hexa3/focus-buddy/BOM.csv

Item | Qty | Supplier | Cost/item | Total Cost | link
Seeed Studio XIAO ESP32-C3 | 1 | Seeed Studio | $4.90 | $4.90 | https://www.seeedstudio.com/Seeed-XIAO-ESP32C3-p-5431.html
2.9" e-paper module, Waveshare V2 | 1 | Waveshare | $21.99 | $21.99 | https://www.waveshare.com/2.9inch-e-paper-module.htm
Printed circuit board (5 pcs, 106x64 mm, 2 layer): paste JLCPCB quote | 1 | JLCPCB | $0.00 | $0.00 | https://jlcpcb.com/quote
Tactile switch 6x6 mm, 9.5 mm tall, through-hole | 3 | Tayda Electronics | $0.04 | $0.12 | https://www.taydaelectronics.com/tact-switch-6x6mm-9-5mm-through-hole-spst-no.html
Resistor 10 kΩ | 4 | Tayda Electronics | $0.02 | $0.08 | https://www.taydaelectronics.com/resistors/1-4w-metal-film-resistors.html
Resistor 1 MΩ | 2 | Tayda Electronics | $0.02 | $0.04 | https://www.taydaelectronics.com/resistors/1-4w-metal-film-resistors.html
Resistor 1 kΩ | 1 | Tayda Electronics | $0.02 | $0.02 | https://www.taydaelectronics.com/resistors/1-4w-metal-film-resistors.html
NPN transistor 2N3904, TO-92 | 1 | Futurlec | $0.06 | $0.06 | https://www.futurlec.com/Transistors/2N3904pr.shtml
Diode 1N4148 | 1 | Tayda Electronics | $0.02 | $0.02
Buzzer 12 mm, 3 V, 7.6 mm pin spacing | 1 | Tayda Electronics | $0.50 | $0.50
Capacitor 100 nF ceramic | 1 | Tayda Electronics | $0.02 | $0.02
Pin header 1x8 male, 2.54 mm | 1 | Tayda Electronics | $0.05 | $0.05
Male pin header 1x7, 2.54 mm | 2 | Tayda Electronics | $0.05 | $0.10
JST-PH 2-pin socket, vertical (B2B-PH-K) | 1 | Tayda Electronics | $0.10 | $0.10
LiPo battery 3.7 V | 1 | Any | $5.00 | $5.00
Screw M3 x 20 mm | 4 | Any hardware store | $0.10 | $0.40
Double-sided foam tape | 1 | Any | $1.00 | $1.00
PLA or PETG filament | 1 | Any | $2.20 | $2.20
Estimated total shipping | 1 |  | $0.00 | $0.00
Estimated total shipping | 1 |  |  | $0.00
