hexa3/focus-buddy/hardware/cad/pcb_positions.scad

// GENERATED by tools/gen_cad_params.py from the PCB. Do not edit by hand.
pcb_w = 106.0;
pcb_h = 64.0;
pcb_holes = [[-49.5, 28.5], [49.5, 28.5], [-49.5, -28.5], [49.5, -28.5]];
pcb_switches = [[-20.0, -23.0], [0.0, -23.0], [20.0, -23.0]];
pcb_display_center = [0.0, 9.0];
display_module = [89.5, 38.0];
pcb_xiao_center = [41.0, 2.0];  // USB-C points +X
pcb_cable_slot = [[-44.5, -4.0], [-40.0, 20.0]];
