hexa3/focus-buddy/JOURNAL.md

# Vicar: devlog

<!-- Generated by Half Life from project k4ep6hjw5rflj7knygj98lg3. Edits here are overwritten on the next sync. -->
<!-- Generated: 2026-11-01T14:42:42.248Z -->

> [!NOTE]
> This devlog is mirrored from [Half Life](https://halflife.hackclub.com) ([open the project](https://halflife.hackclub.com/projects/k4ep6hjw5rflj7knygj98lg3)). Editing it here will not change the platform's copy, and the next sync overwrites this file.

> An e-paper screen that updates over bluetooth that shows a timer and helps you stay on track on work. you can use it to play games if you need a break from working

| Week | Tier | Hours logged | Entries |
| --- | --- | --- | --- |
| Week 4 | Tier 2 | 15h | 2 |

## Contents

1. [2026-11-01: full pomodoro timer with a 2.9 inch e-ink screen and seven screens. idle focus, break etc.](#2026-11-01-full-pomodoro-timer-with-a-29-inch-e-ink-screen-a)
2. [2026-11-01: 1-startup-splash](#2026-11-01-1-startup-splashhttpshalflifehackclub-assetscomse)

## Design

### 2026-11-01: full pomodoro timer with a 2.9 inch e-ink screen and seven screens. idle focus, break etc.

**10h**

full pomodoro timer with a 2.9 inch e-ink screen and seven screens. idle focus, break etc.
three buttons aswell and a long break after 4 session. included power savings. i.e light sleep between screen updates and deep sleep after 3 idle minutes

01-pcb-3d-component-side

02-pcb-3d-button-side

03-pcb-3d-angled

04-pcb-copper-front

05-pcb-copper-back

06-schematic

07-enclosure-exploded

08-enclosure-front-shell-inside

09-enclosure-back-cover

10-firmware-screens

### 2026-11-01: 1-startup-splash

**5h**

1-startup-splash

the buddy has a speech bubble under its face now. when idle it shows the active preset like deep 50/10 so pressing c visibly does something. while focusing it rotates through phrases like let's go, in the zone, keep going, almost there, and final push in the last minute. during breaks it shows reminders like stretch, drink water, look far away, or breathe, and long breaks say go for a walk. when paused it says take your time. on power-up it displays hi there and the a, b, and c controls for 2.5 seconds before starting the timer, which is skipped when waking from sleep. the word mute is replaced with a small muted speaker icon. below 10% battery the bubble says charge me and the sleep screen shows battery low: charge me. the bubble text was also fixed so it uses the small built-in font instead of switching fonts and cramped text, so every message now fits properly.

2-idle-shows-preset

4-break-tips-and-mute-icon

3-focus-encouragement

5-low-battery
