hexa3/focus-buddy/hardware/pcb/focus-buddy.kicad_pcb

## KiCad design hardware/pcb/focus-buddy.kicad_pcb (2026-11-01)

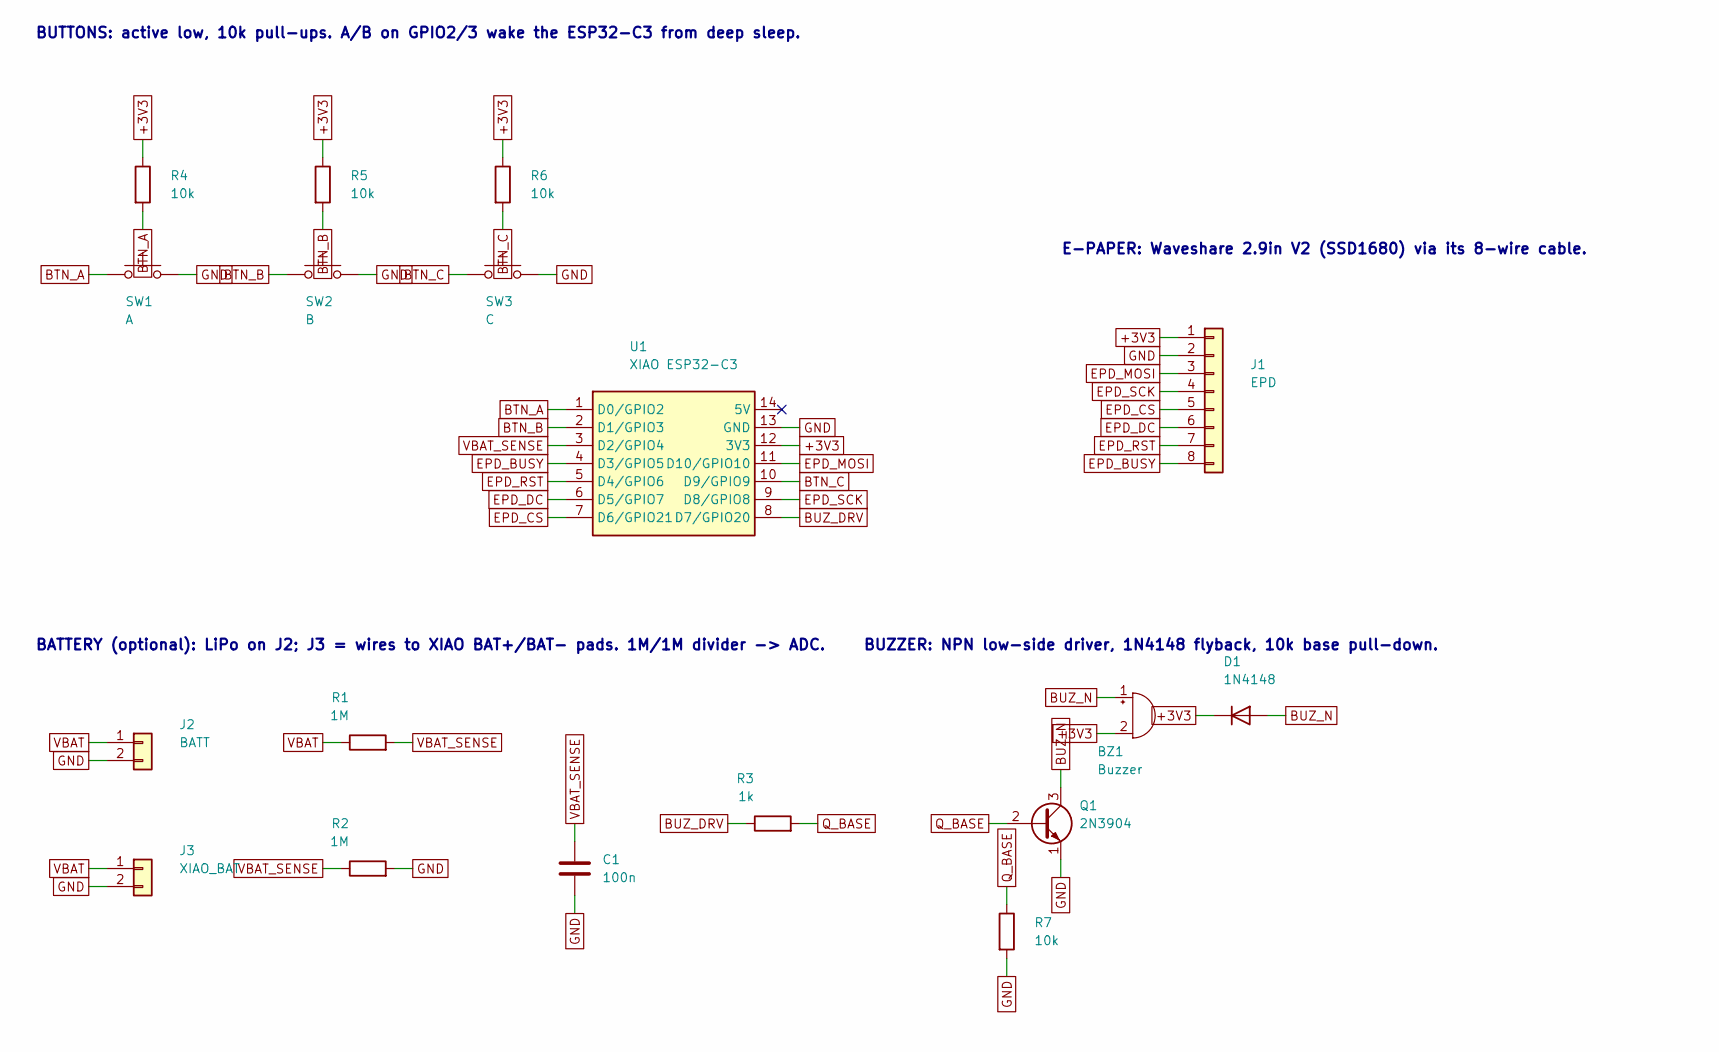
[picture p7: schematic focus-buddy.kicad_sch, Focus Buddy - e-ink Pomodoro desk companion]

Parts:
BZ1: Buzzer; Buzzer_12x9.5RM7.6
C1: 100n; C_Disc_D5.0mm_W2.5mm_P5.00mm
D1: 1N4148; D_DO-35_SOD27_P7.62mm_Horizontal
J1: EPD; PinHeader_1x08_P2.54mm_Vertical
J2: BATT; JST_PH_B2B-PH-K_1x02_P2.00mm_Vertical
J3: XIAO_BAT; PinHeader_1x02_P2.54mm_Vertical
Q1: 2N3904; TO-92_Inline_Wide
R1, R2: 1M; R_Axial_DIN0207_L6.3mm_D2.5mm_P7.62mm_Horizontal
R3: 1k; R_Axial_DIN0207_L6.3mm_D2.5mm_P7.62mm_Horizontal
R4, R5, R6, R7: 10k; R_Axial_DIN0207_L6.3mm_D2.5mm_P7.62mm_Horizontal
SW1: A; SW_PUSH_6mm_H9.5mm
SW2: B; SW_PUSH_6mm_H9.5mm
SW3: C; SW_PUSH_6mm_H9.5mm
U1: XIAO ESP32-C3; Seeed_XIAO_THT

Connections:
+3V3: BZ1.2 (-), D1.1 (K), J1.1, R4.1, R5.1, R6.1, U1.12 (3V3)
BTN_A: R4.2, SW1.1, U1.1 (D0/GPIO2)
BTN_B: R5.2, SW2.1, U1.2 (D1/GPIO3)
BTN_C: R6.2, SW3.1, U1.10 (D9/GPIO9)
BUZ_DRV: R3.1, U1.8 (D7/GPIO20)
BUZ_N: BZ1.1 (+), D1.2 (A), Q1.3 (C)
EPD_BUSY: J1.8, U1.4 (D3/GPIO5)
EPD_CS: J1.5, U1.7 (D6/GPIO21)
EPD_DC: J1.6, U1.6 (D5/GPIO7)
EPD_MOSI: J1.3, U1.11 (D10/GPIO10)
EPD_RST: J1.7, U1.5 (D4/GPIO6)
EPD_SCK: J1.4, U1.9 (D8/GPIO8)
GND: C1.2, J1.2, J2.2, J3.2, Q1.1 (E), R2.2, R7.2, SW1.2, SW2.2, SW3.2, U1.13 (GND)
Q_BASE: Q1.2 (B), R3.2, R7.1
VBAT: J2.1, J3.1, R1.1
VBAT_SENSE: C1.1, R1.2, R2.1, U1.3 (D2/GPIO4)

Notes on the sheet:
BUTTONS: active low, 10k pull-ups. A/B on GPIO2/3 wake the ESP32-C3 from deep sleep.
BATTERY (optional): LiPo on J2; J3 = wires to XIAO BAT+/BAT- pads. 1M/1M divider -> ADC.
BUZZER: NPN low-side driver, 1N4148 flyback, 10k base pull-down.
E-PAPER: Waveshare 2.9in V2 (SSD1680) via its 8-wire cable.

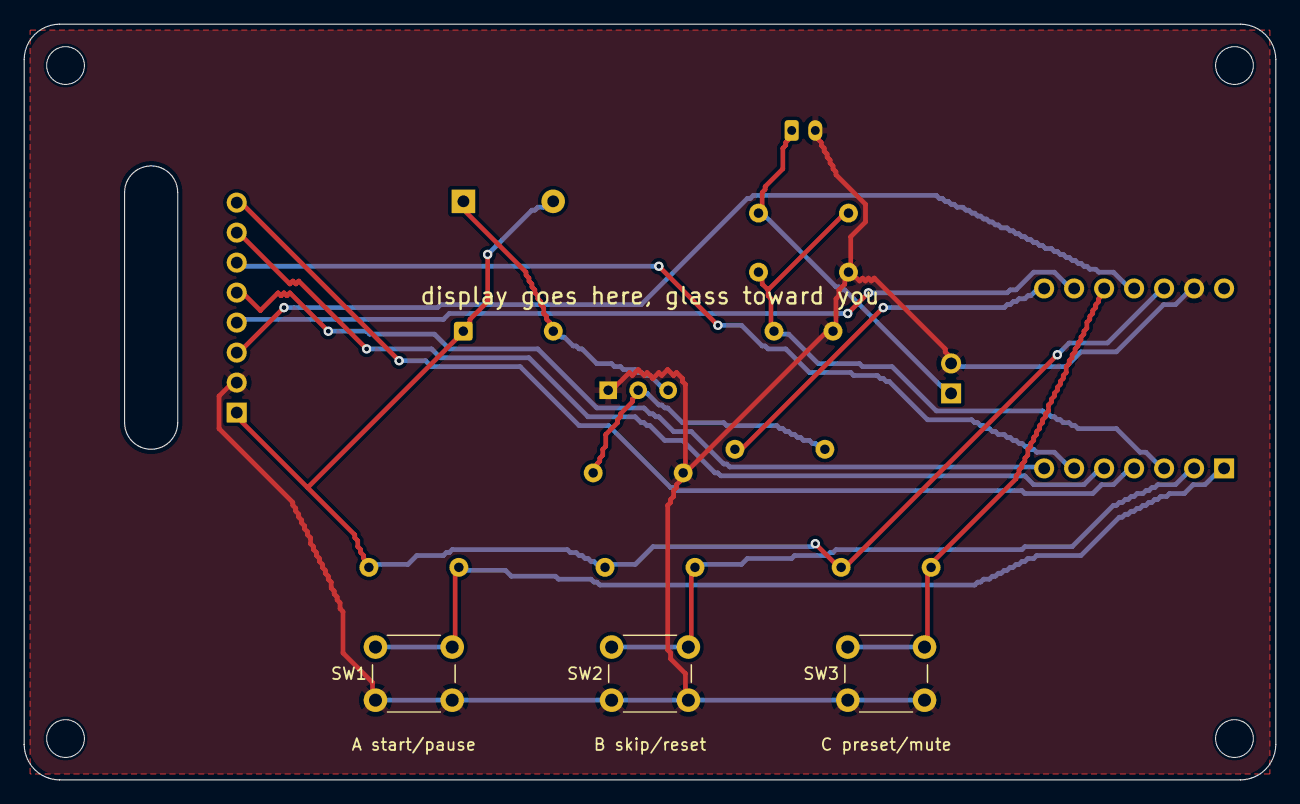
[picture p8: board focus-buddy.kicad_pcb from above]

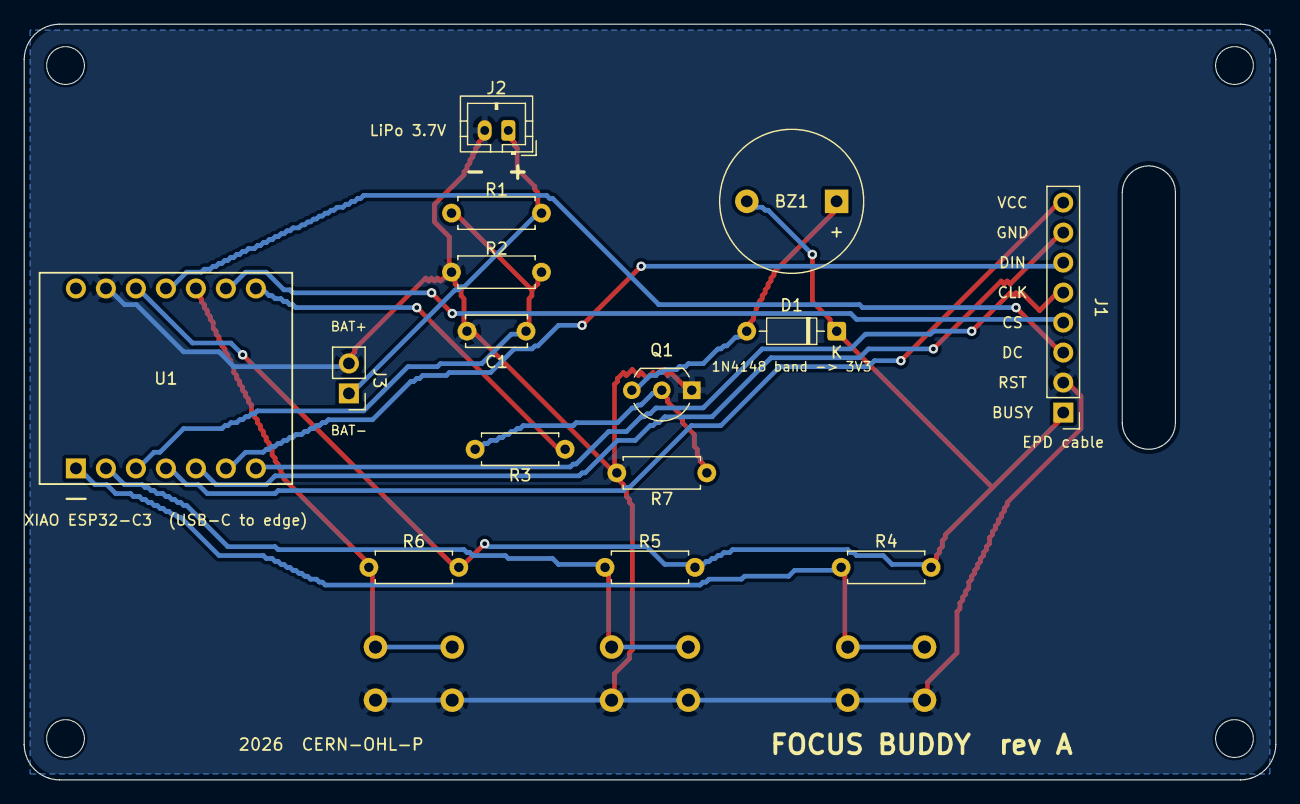
[picture p9: board focus-buddy.kicad_pcb from below]

Board: 2 copper layers, 106.0 x 64.0 mm, 22 parts (15 on the bottom side), 16 nets.

Other parts of the board:
H1, H2, H3, H4: MountingHole_3.2mm_M3
