hexa3/focus-buddy/(commit log)

2026-11-01 Focus Buddy: e-ink Pomodoro desk companion, rev A sources
    - Firmware (PlatformIO, XIAO ESP32-C3 + 2.9" SSD1680 e-paper): timer
    state machine, light/deep sleep, buzzer, 4 panel variants. Screen
    drawing in ui.cpp: big-number layout, speech bubble, splash, mute
    icon, low-battery nudge.
    - Desktop simulator that compiles ui.cpp natively for previews.
    - KiCad 9 project generated from tools/netlist.py: schematic, 2-layer
    through-hole PCB routed by tools/route_pcb.py (DRC 0 errors,
    schematic parity 0 issues), project libraries.
    - Parametric OpenSCAD enclosure with positions taken from the PCB.
    - tools/make_all.sh regenerates Gerbers, STLs, STEP, BOM, reports.
    - Build guide and video render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
    [enclosure.scad, focus-buddy.kicad_pcb, focus-buddy.kicad_sch, pcb_positions.scad]
2026-11-01 README: add 6 pictures of the project
    Screens from the current firmware (simulator), KiCad 3D render, routed
    back copper, exploded enclosure, schematic, and the speech-bubble
    before/after. Stored in docs/readme/ (docs/images/ stays ignored).
2026-11-01 Sync Vicar from Half Life
    [BOM.csv]
2026-11-01 Add complete BOM: every part, tool and consumable to build one
    hardware/BOM.csv is now committed. It is generated by tools/gen_bom.py
    from netlist.py plus off-board items, grouped by category: PCB
    electronics (by value), display, battery, PCB, mechanical, printed
    parts (volumes measured from the STLs: 85.7 cm3, <=106 g PLA solid),
    consumables, tools and software, with a Required/Optional column.
    [BOM.csv]
2026-11-01 Fill Half Life BOM.csv with parts, suppliers, prices and links
    Keeps the platform's column format and shipping row. Verified prices:
    XIAO ESP32-C3 $4.90 (Seeed), Waveshare 2.9" module SKU 12956 $21.99,
    tactile switches and resistors (Tayda), 2N3904 (Futurlec). Rows
    without a confirmed price are marked "(price est.)" with no link.
    PCB is "quote": 106 mm wide is outside JLCPCB's 100x100 mm $2 tier.
    Full build list incl. tools/consumables stays in hardware/BOM.csv.
    [BOM.csv]
2026-11-01 Add hardware/BOM-halflife.csv: priced BOM in Half Life's format for import
    Half Life imported items from hardware/BOM.csv (no price column), so
    every line showed $0.00, and its sync overwrites the root BOM.csv.
    This file uses the platform's columns and item names with real
    quantities and prices (XIAO $4.90, display $21.99, etc.).
    PCB is left as 'quote' (106 mm is outside the $2 tier).
    [BOM-halflife.csv]
2026-11-01 Use the priced BOM as the root BOM.csv
    Replaces the $0.00 copy synced from Half Life with the priced list
    (previously hardware/BOM-halflife.csv).
    [BOM-halflife.csv, BOM.csv]
2026-11-01 Move the priced BOM back to hardware/BOM-halflife.csv
    Reverts cb0f0ba: the root BOM.csv returns to the version synced from
    Half Life.
    [BOM-halflife.csv, BOM.csv]
