hexa3/focus-buddy/(notices)

Notices in the files:
hardware/pcb/focus-buddy.kicad_pcb:
open hardware, CERN-OHL-P
2026 CERN-OHL-P
